Kaveesha229/Liquid-based-dynamic-counterweight-system-to-optimize-elevator-energy-usage-based-on-load./Screenshot (775).png

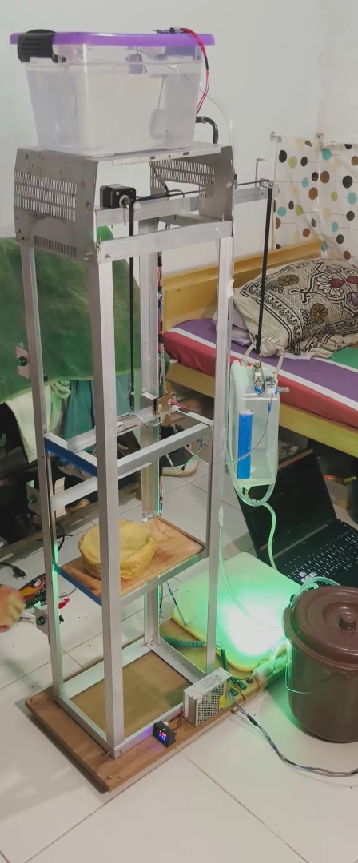
Screenshot (775).png
